zachlambert/pcb-stm32f103c8tx-breakout/stm32f103c8tx_breakout.kicad_pcb

## KiCad design stm32f103c8tx_breakout.kicad_pcb (2022-08-05)

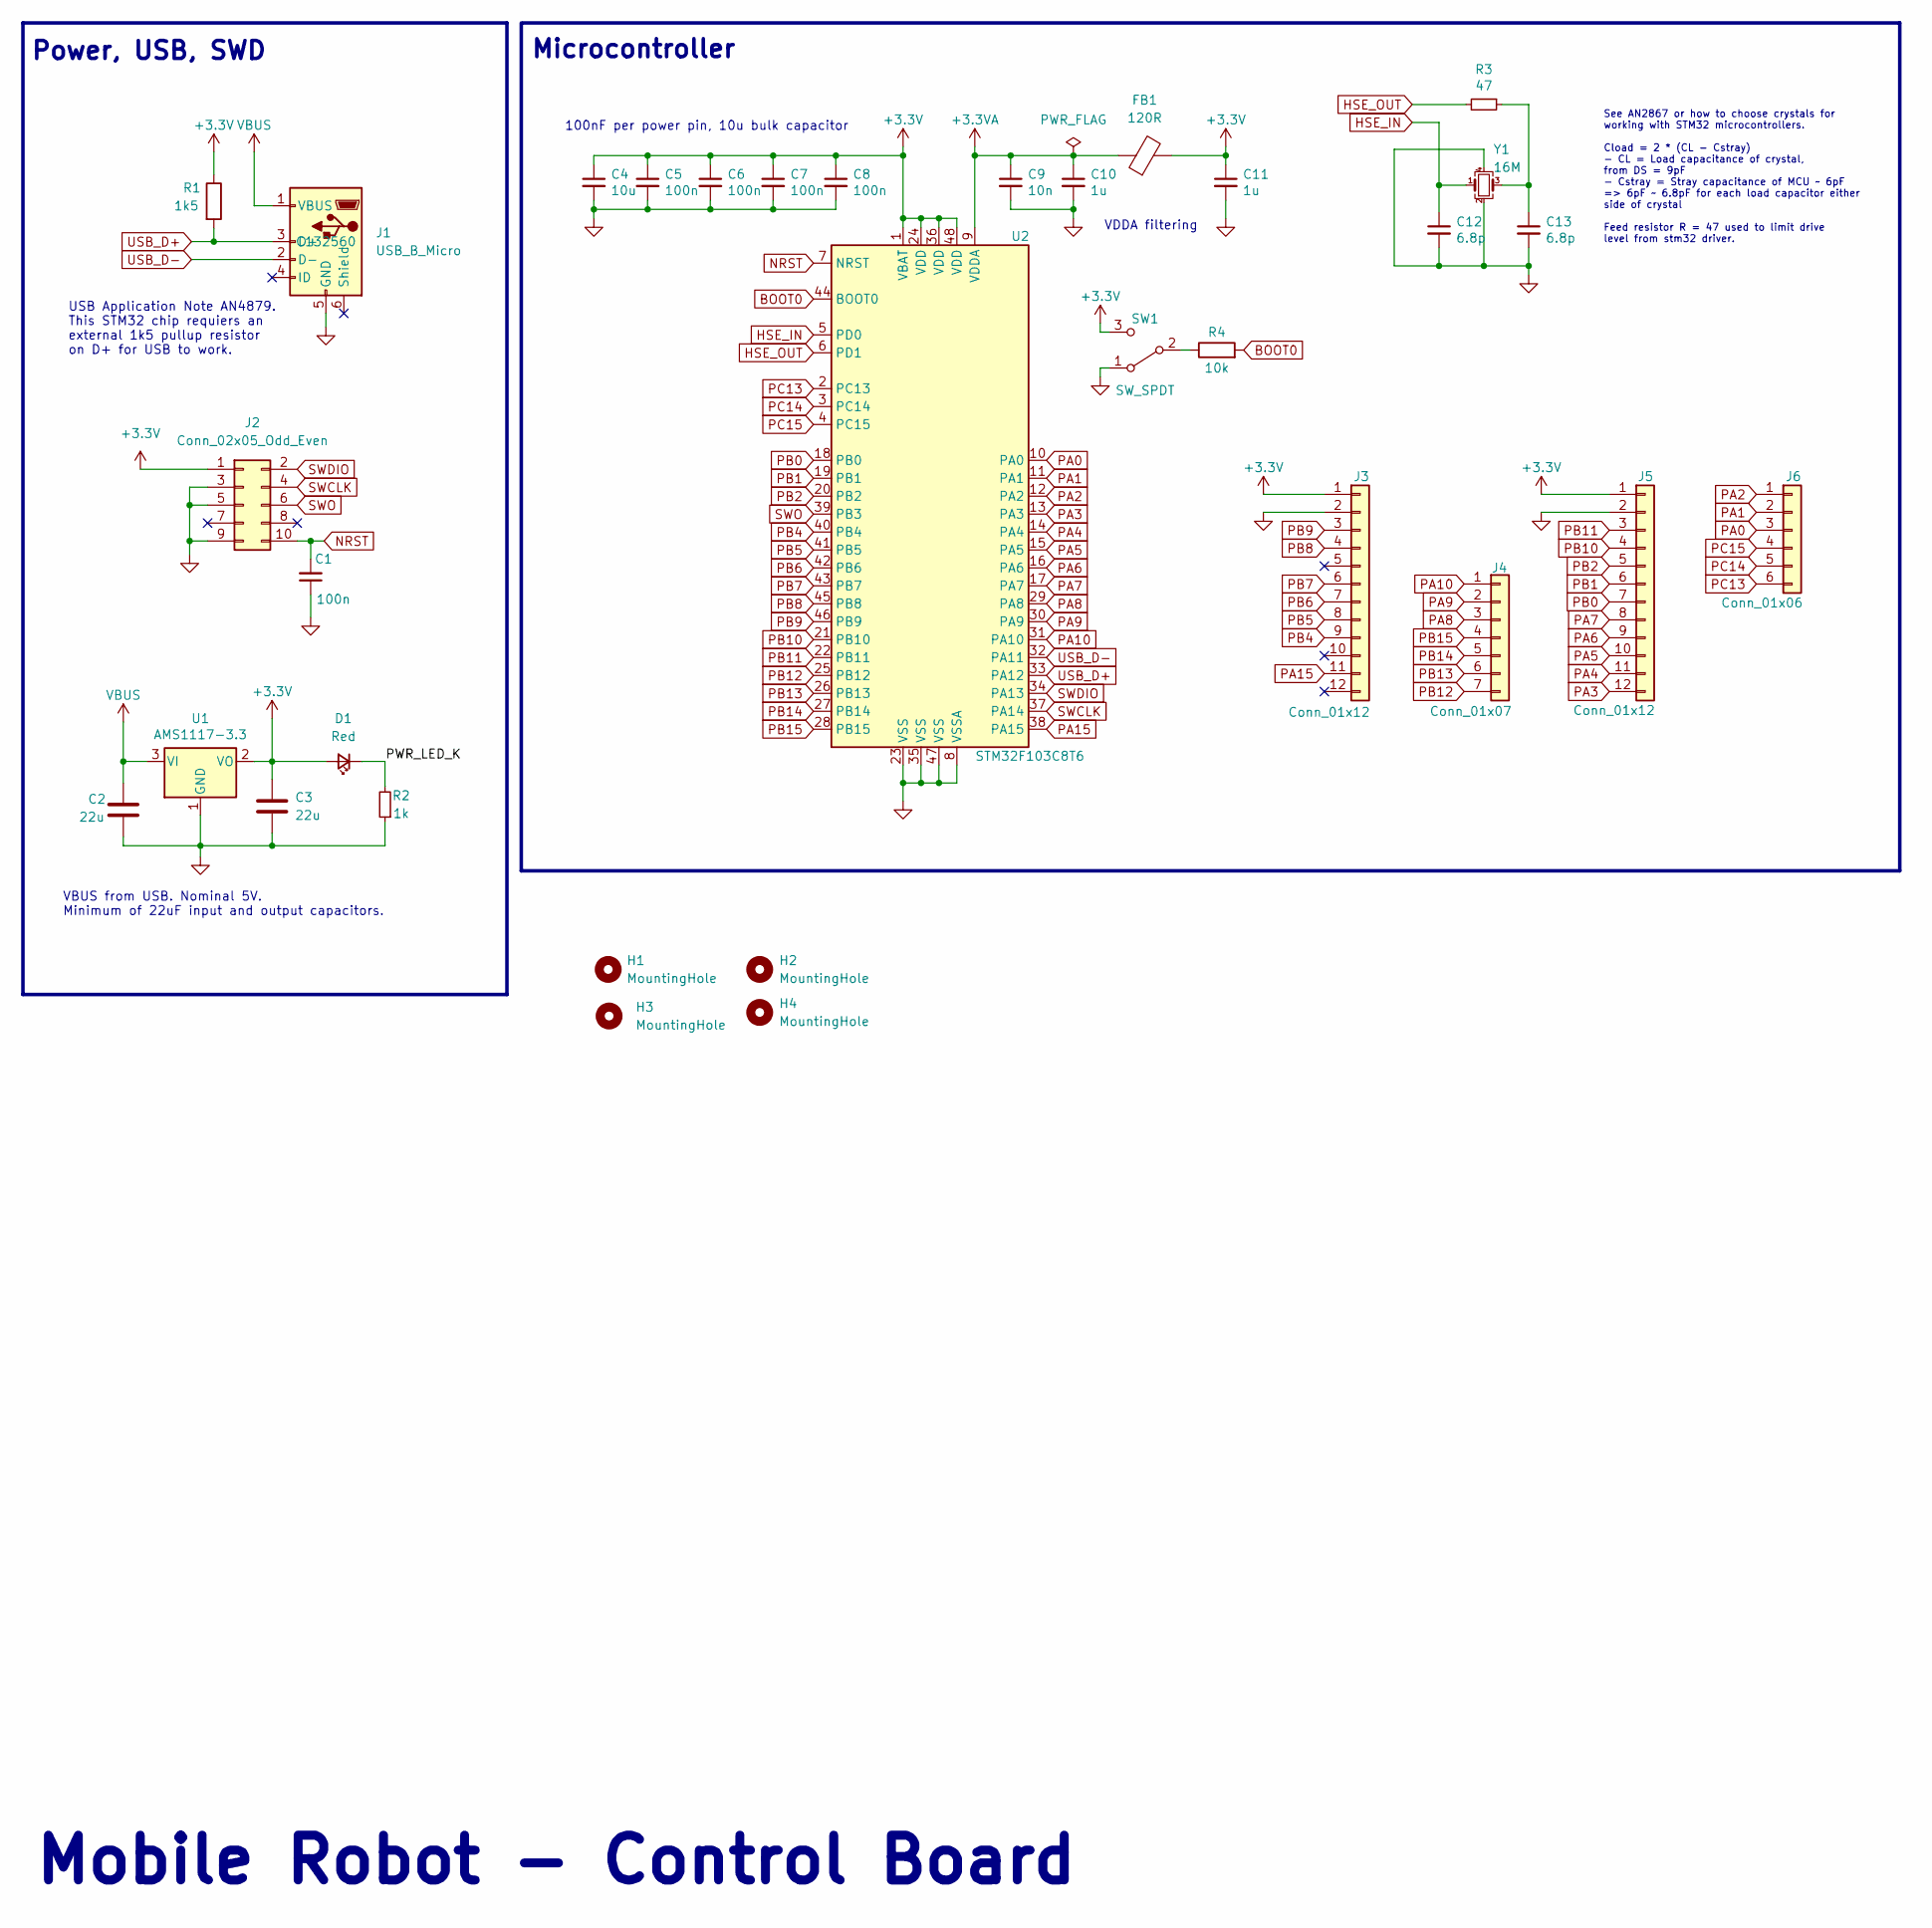
[picture p1: schematic stm32f103c8tx_breakout.kicad_sch]

Parts:
C1, C5, C6, C7, C8: 100n; C_0402_1005Metric
C2, C3: 22u; C_0805_2012Metric
C4: 10u; C_0603_1608Metric
C9: 10n; C_0402_1005Metric
C10, C11: 1u; C_0402_1005Metric
C12, C13: 6.8p; C_0402_1005Metric
D1: Red; D_0603_1608Metric
FB1: 120R; L_0603_1608Metric
H1, H2, H3, H4: MountingHole; MountingHole_3.2mm_M3
J1: USB_B_Micro; USB_Micro-B_Molex_47346-0001; LCSC C132560
J2: Conn_02x05_Odd_Even; PinHeader_2x05_P2.54mm_Vertical; LCSC C492422
J3, J5: Conn_01x12; PinSocket_1x12_P2.54mm_Vertical
J4: Conn_01x07; PinSocket_1x07_P2.54mm_Vertical
J6: Conn_01x06; PinSocket_1x06_P2.54mm_Vertical
R1: 1k5; R_0402_1005Metric
R2: 1k; R_0402_1005Metric
R3: 47; R_0402_1005Metric
R4: 10k; R_0402_1005Metric
SW1: SW_SPDT; SW_SPDT_PCM12
U1: AMS1117-3.3; SOT-223-3_TabPin2; LCSC C6186
U2: STM32F103C8T6; LQFP-48_7x7mm_P0.5mm; LCSC C8734
Y1: 16M; Crystal_SMD_3225-4Pin_3.2x2.5mm; LCSC C13738

Connections:
+3.3VA: C9.1, C10.1, FB1.1, U2.9 (VDDA)
+3V3: C3.1, C4.1, C5.1, C6.1, C7.1, C8.1, C11.1, D1.2 (A), FB1.2, J2.1, J3.1, J5.1, R1.1, SW1.3 (C), U1.2 (VO), U2.1 (VBAT), U2.24 (VDD), U2.36 (VDD), U2.48 (VDD)
/PWR_LED_K: D1.1 (K), R2.2
BOOT0: R4.2, U2.44 (BOOT0)
GND: C1.1, C2.2, C3.2, C4.2, C5.2, C6.2, C7.2, C8.2, C9.2, C10.2, C11.2, C12.2, C13.2, J1.5 (GND), J2.3, J2.5, J2.9, J3.2, J5.2, R2.1, SW1.1 (A), U1.1 (GND), U2.8 (VSSA), U2.23 (VSS), U2.35 (VSS), U2.47 (VSS), Y1.2, Y1.4
HSE_IN: C12.1, U2.5 (PD0), Y1.1
HSE_OUT: R3.2, U2.6 (PD1)
NRST: C1.2, J2.10, U2.7 (NRST)
unnamed: C13.1, R3.1, Y1.3
unnamed: R4.1, SW1.2 (B)
PA0: J6.3, U2.10 (PA0)
PA1: J6.2, U2.11 (PA1)
PA2: J6.1, U2.12 (PA2)
PA3: J5.12, U2.13 (PA3)
PA4: J5.11, U2.14 (PA4)
PA5: J5.10, U2.15 (PA5)
PA6: J5.9, U2.16 (PA6)
PA7: J5.8, U2.17 (PA7)
PA8: J4.3, U2.29 (PA8)
PA9: J4.2, U2.30 (PA9)
PA10: J4.1, U2.31 (PA10)
PA15: J3.11, U2.38 (PA15)
PB0: J5.7, U2.18 (PB0)
PB1: J5.6, U2.19 (PB1)
PB2: J5.5, U2.20 (PB2)
PB4: J3.9, U2.40 (PB4)
PB5: J3.8, U2.41 (PB5)
PB6: J3.7, U2.42 (PB6)
PB7: J3.6, U2.43 (PB7)
PB8: J3.4, U2.45 (PB8)
PB9: J3.3, U2.46 (PB9)
PB10: J5.4, U2.21 (PB10)
PB11: J5.3, U2.22 (PB11)
PB12: J4.7, U2.25 (PB12)
PB13: J4.6, U2.26 (PB13)
PB14: J4.5, U2.27 (PB14)
PB15: J4.4, U2.28 (PB15)
PC13: J6.6, U2.2 (PC13)
PC14: J6.5, U2.3 (PC14)
PC15: J6.4, U2.4 (PC15)
SWCLK: J2.4, U2.37 (PA14)
SWDIO: J2.2, U2.34 (PA13)
SWO: J2.6, U2.39 (PB3)
USB_D+: J1.3 (D+), R1.2, U2.33 (PA12)
USB_D-: J1.2 (D-), U2.32 (PA11)
VBUS: C2.1, J1.1 (VBUS), U1.3 (VI)

Notes on the sheet:
USB Application Note AN4879. This STM32 chip requiers an external 1k5 pullup resistor on D+ for USB to work.
VDDA filtering
Power, USB, SWD
See AN2867 or how to choose crystals for working with STM32 microcontrollers. Cload = 2 * (CL - Cstray) - CL = Load capacitance of crystal, from DS = 9pF - Cstray = Stray capacitance of MCU ~ 6pF => 6pF ~ 6.8pF for each load capacitor either side of crystal Feed resistor R = 47 used to limit drive 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
Mobile Robot - Control Board
100nF per power pin, 10u bulk capacitor
Microcontroller
VBUS from USB. Nominal 5V. Minimum of 22uF input and output capacitors.

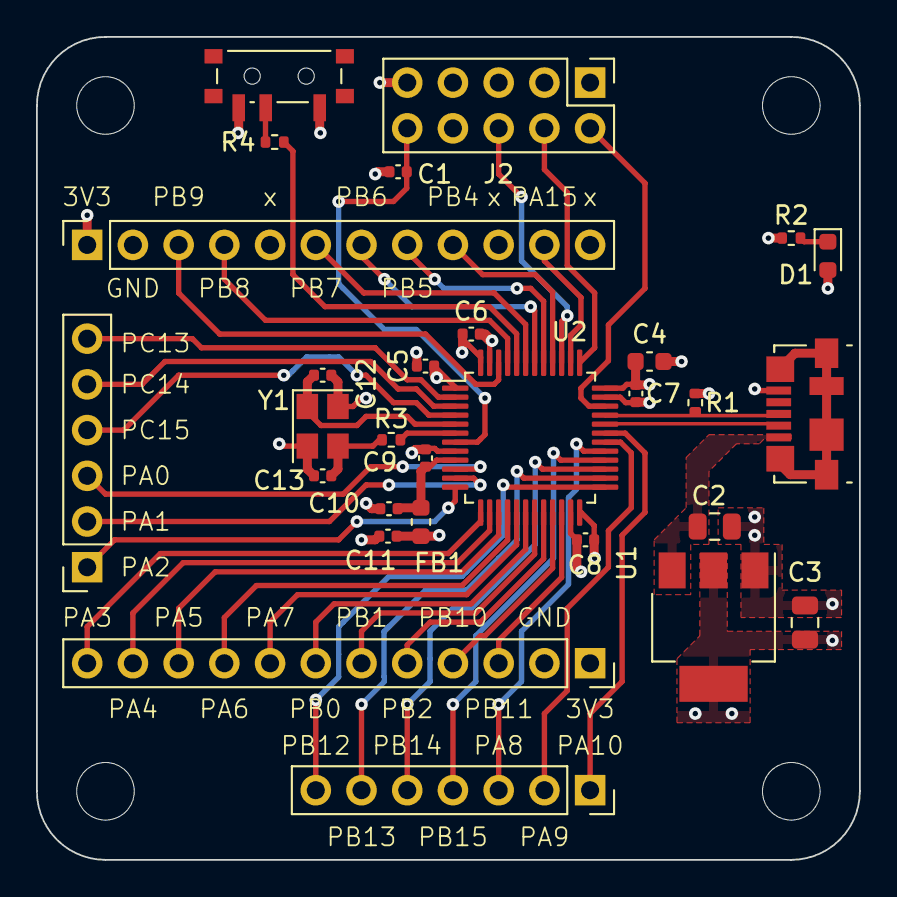
[picture p2: board stm32f103c8tx_breakout.kicad_pcb from above]

Board: 4 copper layers, 45.7 x 45.7 mm, 33 parts (0 on the bottom side), 46 nets.
