zachlambert/pcb-stm32f103c8tx-breakout/(commit log)

2022-08-05 Completed 2 layer board, going to try routing with 4 layers instead
    [stm32f103c8tx_breakout.kicad_pcb, stm32f103c8tx_breakout.kicad_sch]
2022-08-05 Changed routing to use 4 layers, with internal gnd and 3v3 planes
    [stm32f103c8tx_breakout.kicad_pcb]
2024-06-17 Changes to fix for jlcpcb parts
    [stm32f103c8tx_breakout.kicad_sch]
